BartekChelminski/-CD4093B-TSMC-180-nm-1P6M-1.8V/README.md

# CD4093B TSMC 180nm 1P6M 1.8V
Copy of a CD4093B integrated circuit (4 2-Input NAND Schmitt Triggers) made in TSMC 180 nm 1P6M 1.8V technology. Designed as a university project using LTspice and Magic VLSI.

Detailed presentation and simulation results are in the pdf file in folder docs.

# Images
## Functional diagram
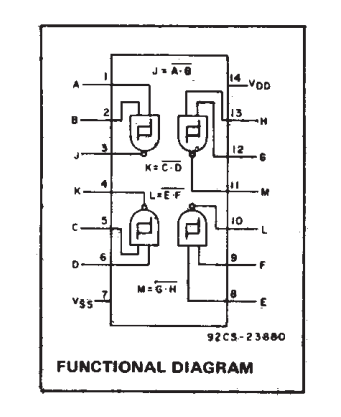
[picture p1: img/functional_diagram.png]
Functional diagram

## Full chip layout
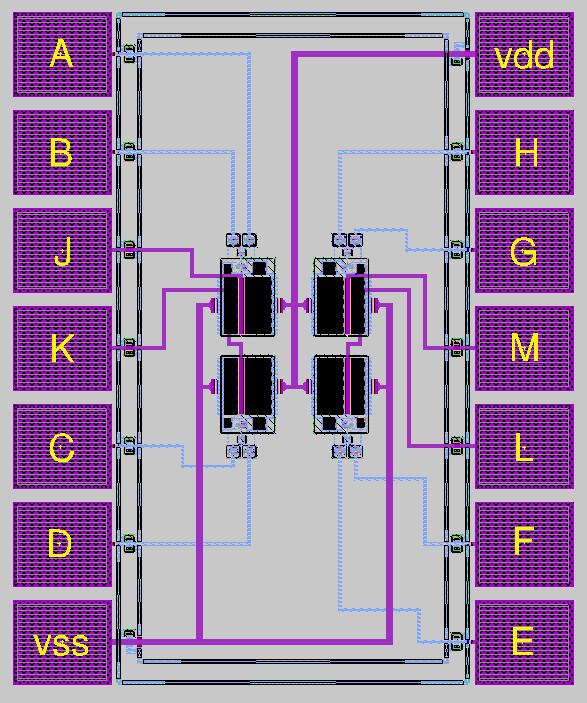
[picture p2: img/layout.png]
Layout

## Single Gate layout
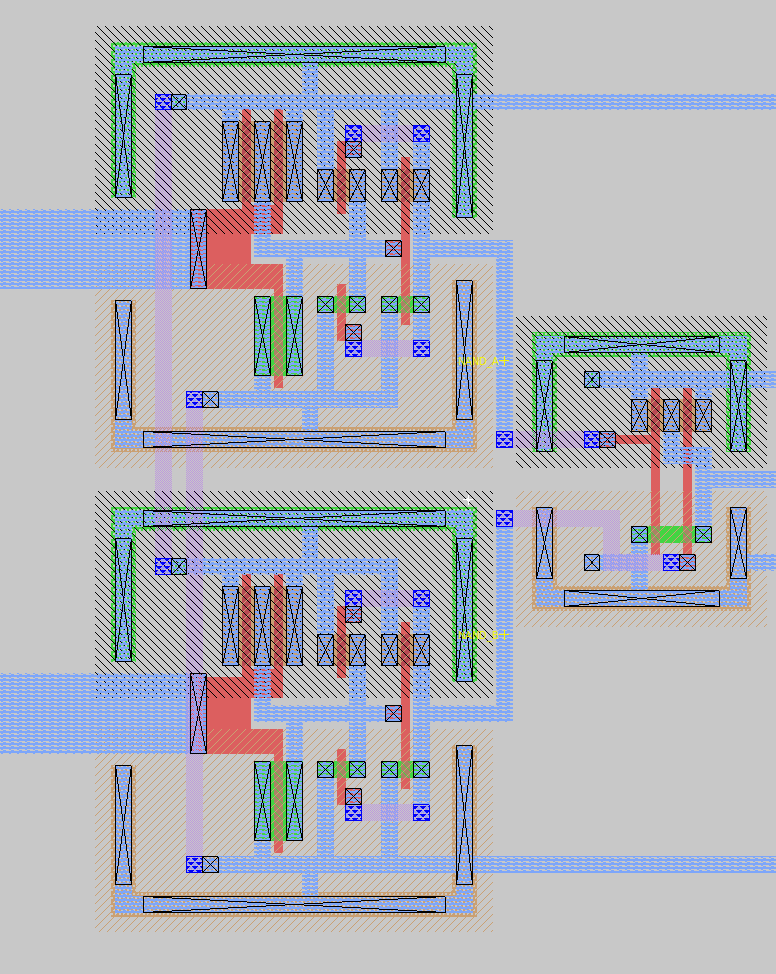
[picture p3: img/nand_schmitt.png]
nand_schmitt
