BartekChelminski/-CD4093B-TSMC-180-nm-1P6M-1.8V/doc/[ENG]project_presentation.pdf

Project topic: CD4093B

4 NAND gates with hysteresis


Project requirements

- Technology: CMOS TSMC 180 nm, 1P6M, 1.8 V
- Latch-up protection
- Electromigration protection
- PAD cells with dimensions (width × length): 60 µm × 70 µm, in no-devices-under-pad configuration
- ESD protection implemented using diodes or transistors
- Output current drive capability: IO ≥ 15 mA (DC) under conditions:
- VDD = 1.8 V ±10%
- Temperature range: −30°C to +125°C
- Output frequency: at least 30 MHz with 25 pF load, under conditions:
- VDD = 1.8 V ±10%
- Temperature range: −30°C to +125°C

Single gate schematic

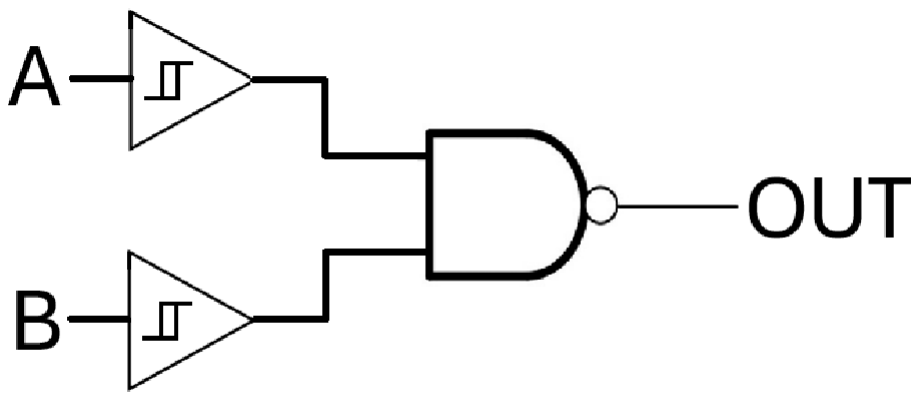
[picture p4: figure]

NAND gate

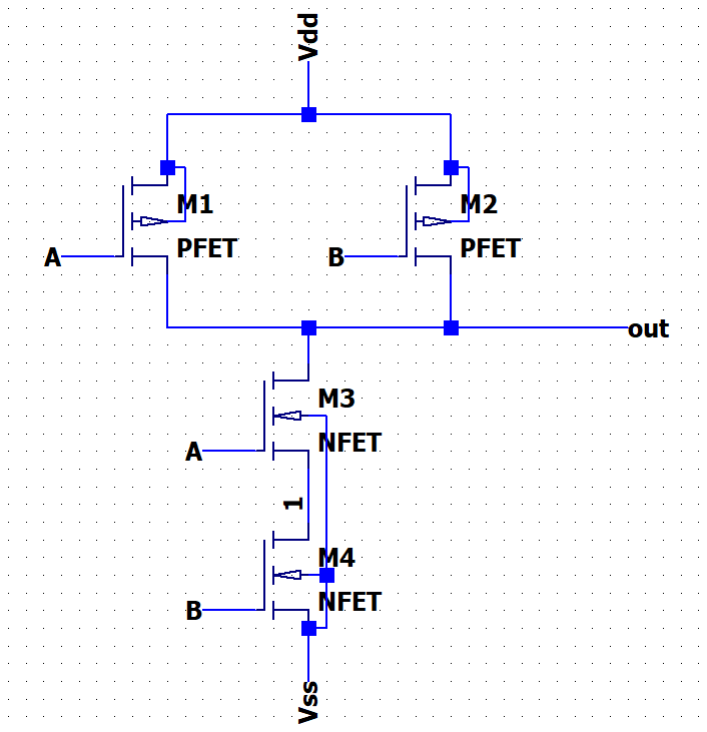
[picture p5: figure]
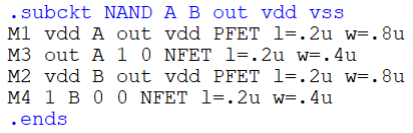
[picture p6: figure]
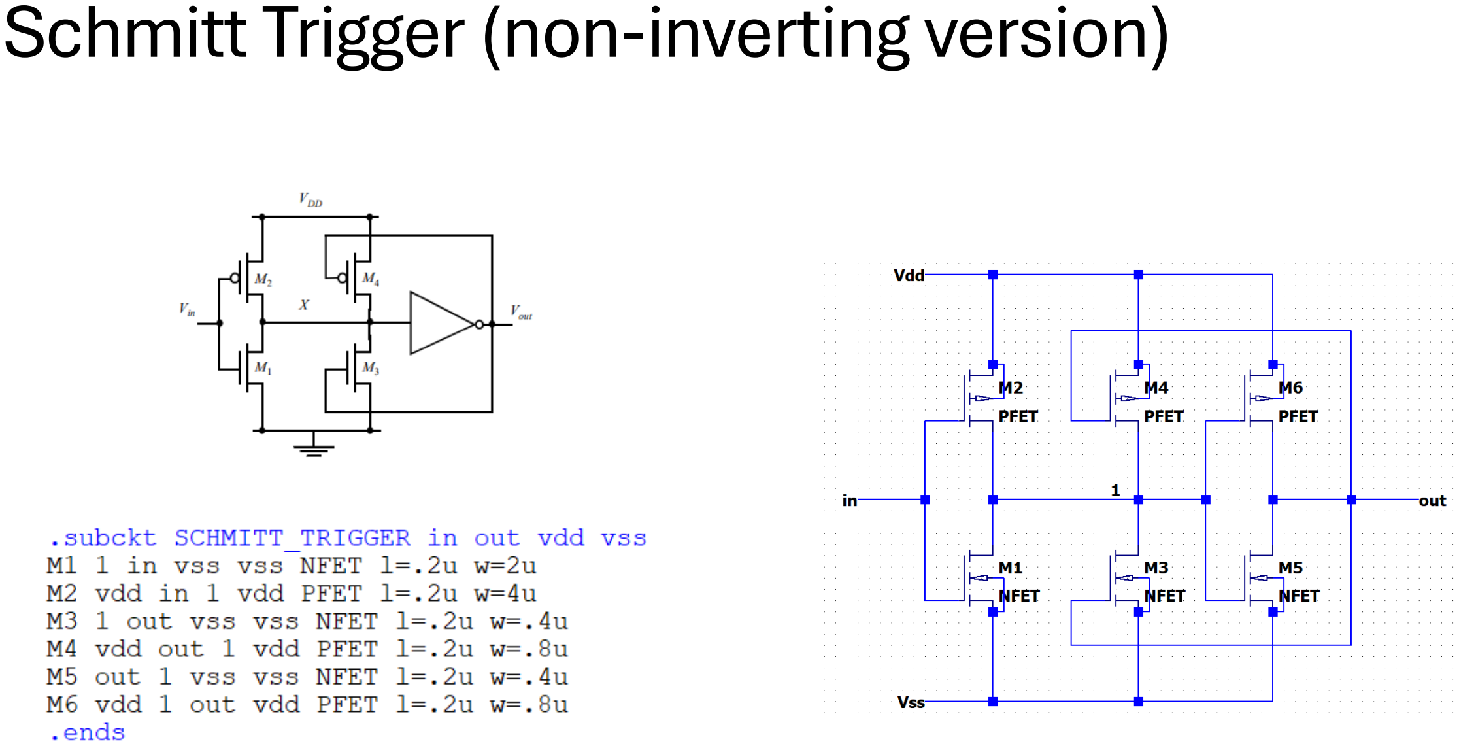
[picture p7: page 5]

Schmitt Trigger (non-inverting version)

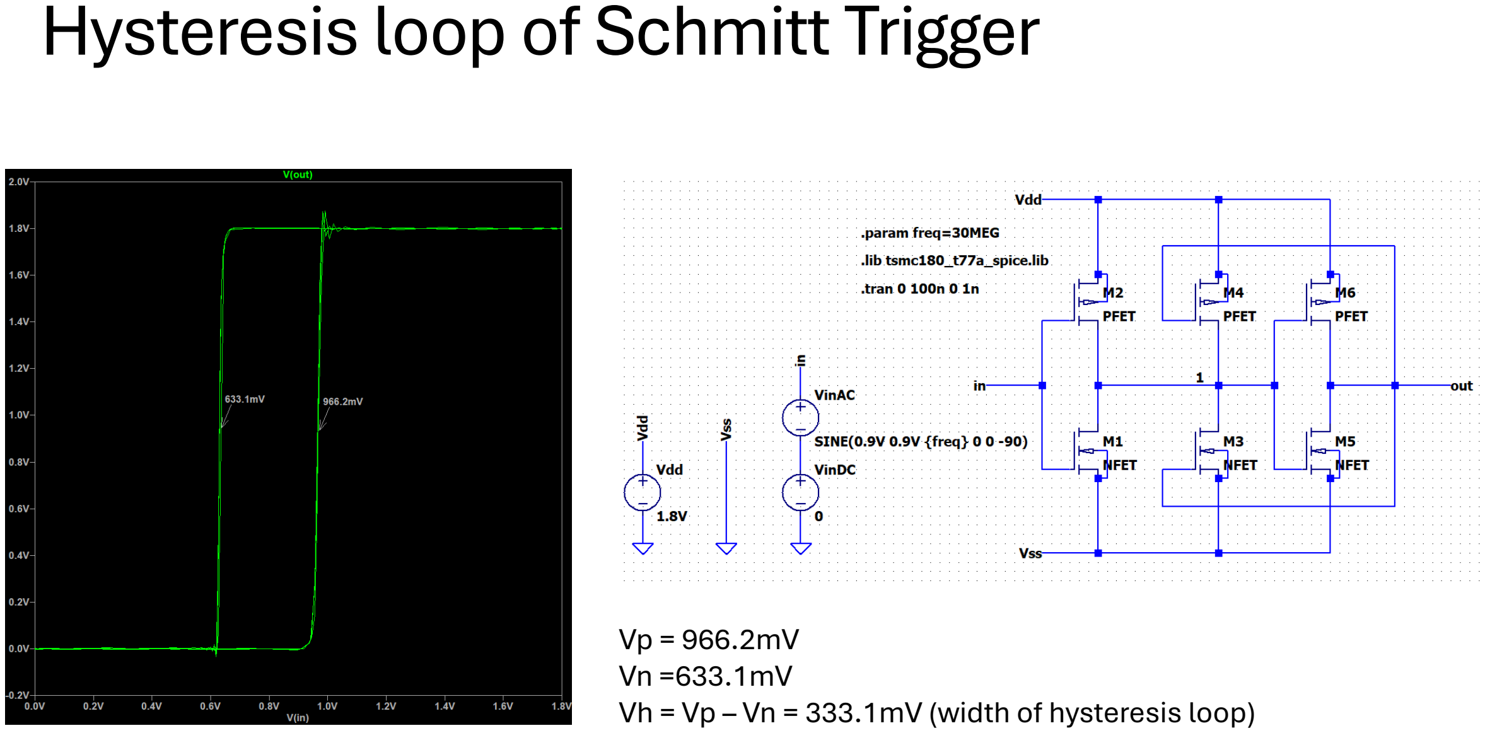
[picture p8: page 6]

Hysteresis loop of Schmitt Trigger

Vp = 966.2mV
Vn =633.1mV
Vh = Vp – Vn = 333.1mV (width of hysteresis loop)

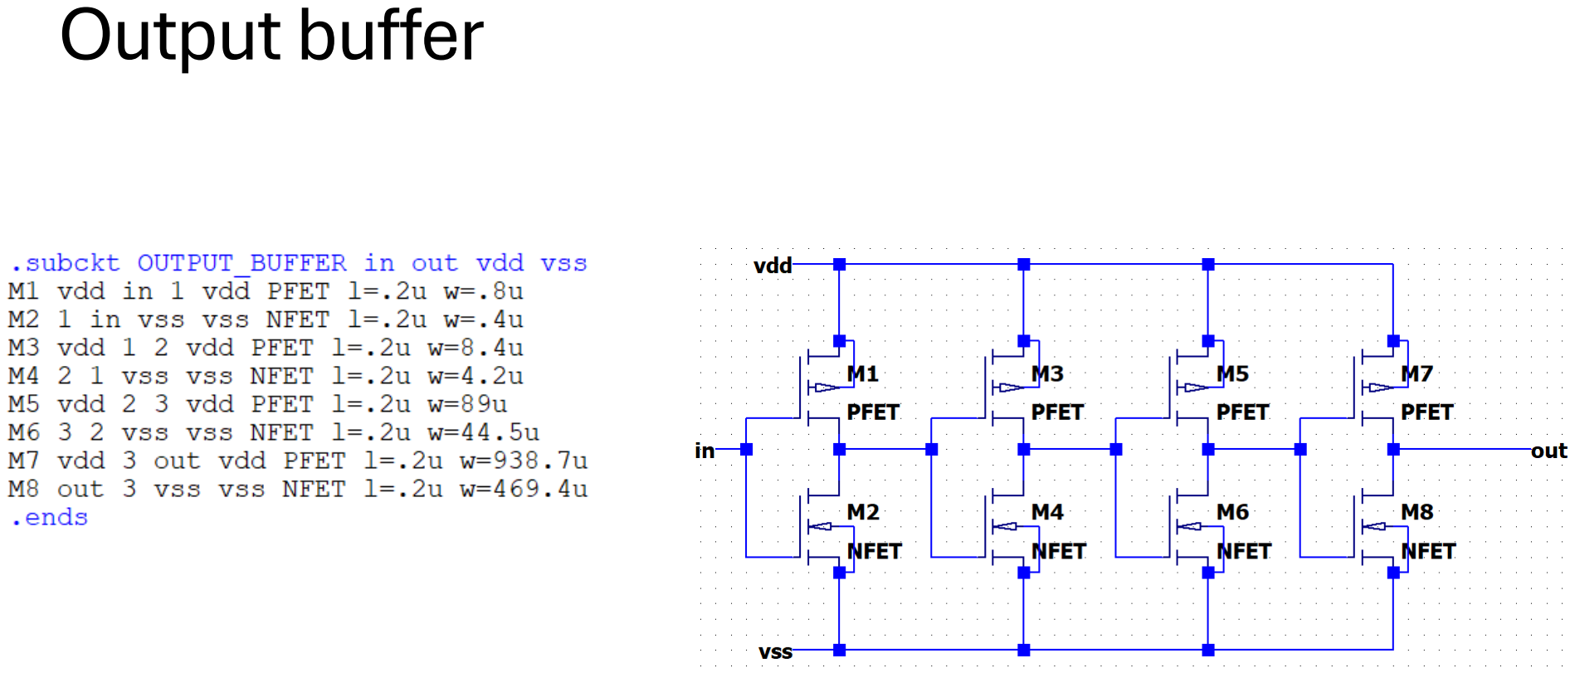
[picture p9: page 7]

Output buffer

Theoretical calculations for buffer design

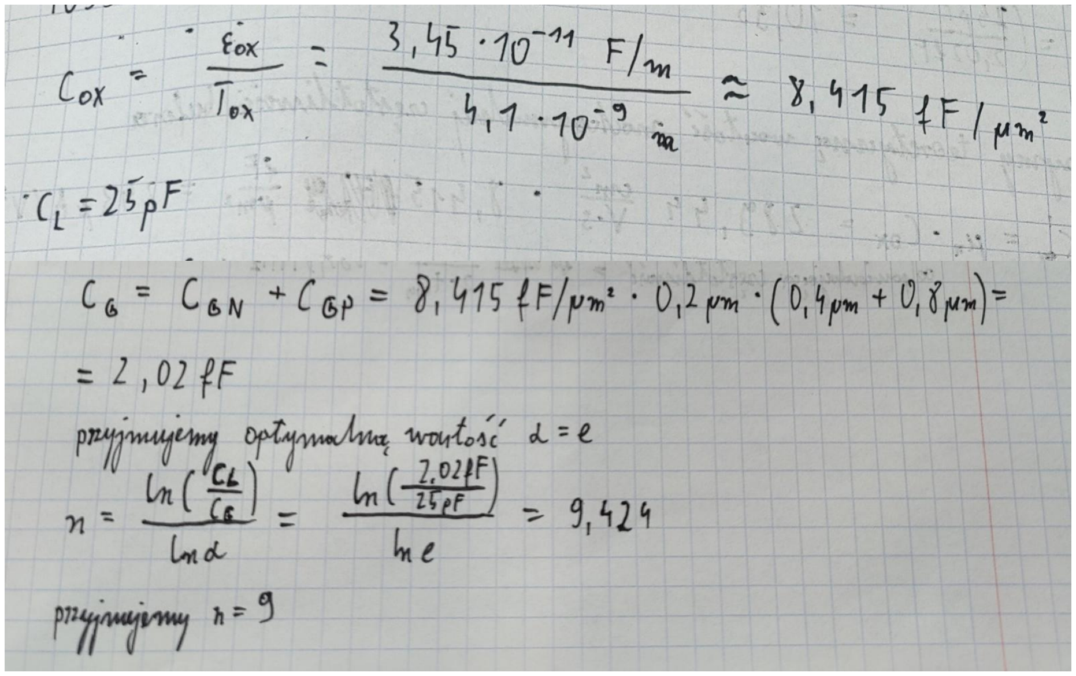
[picture p10: figure]

Theoretical calculations for buffer design

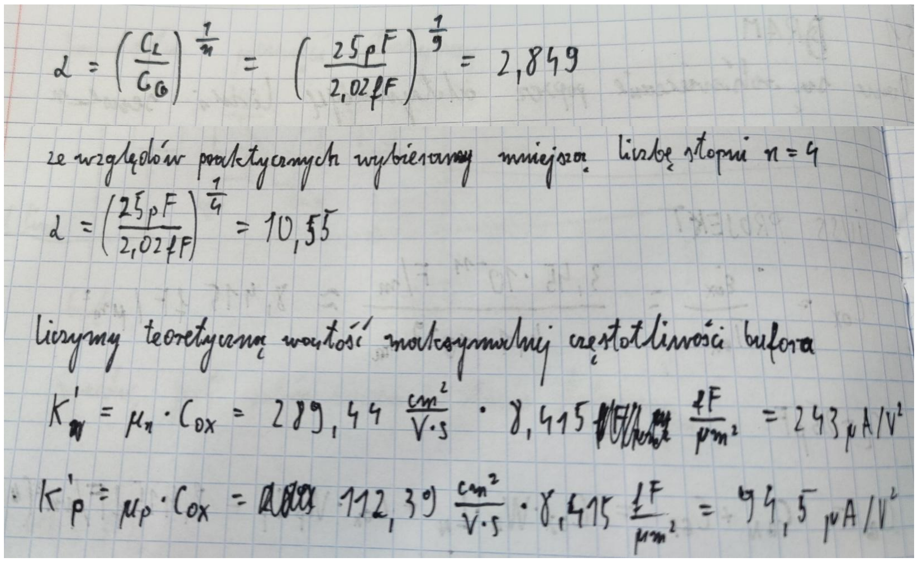
[picture p11: figure]

Theoretical calculations for buffer design

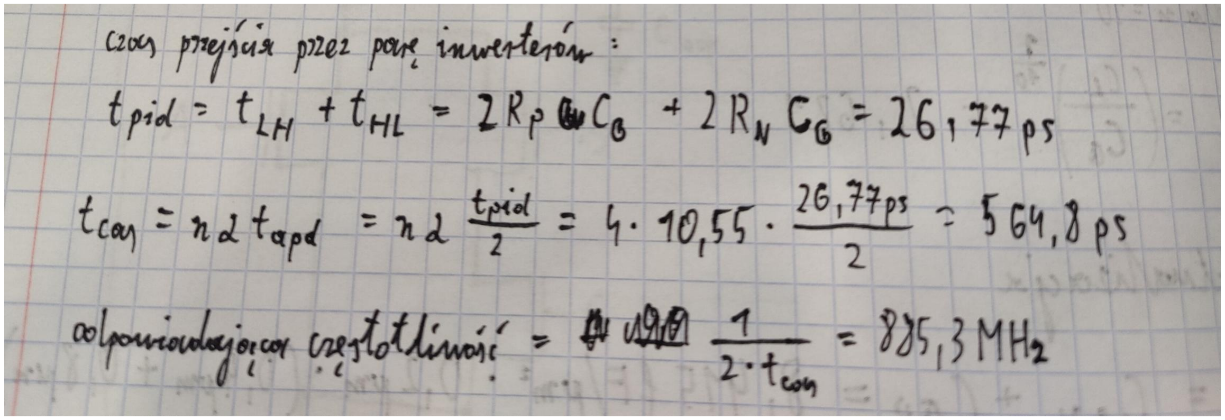
[picture p12: figure]

Buffer output waveform at 30 MHz

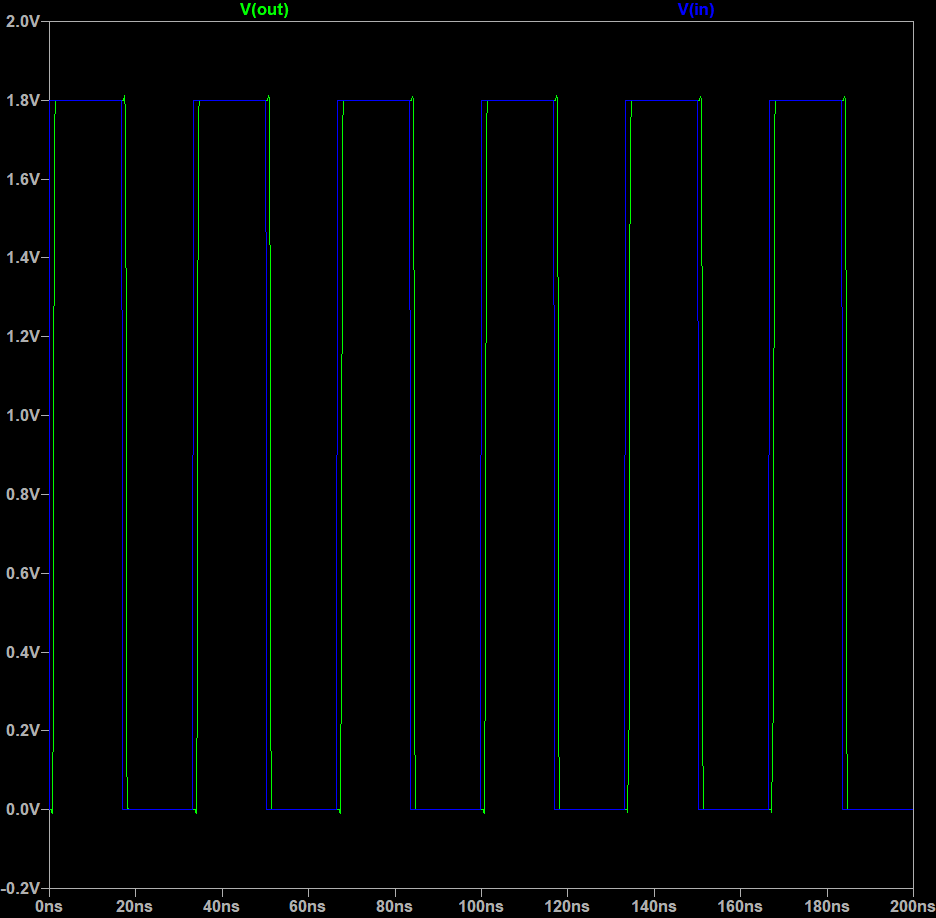
[picture p13: figure]

Buffer output waveform at 30 MHz for maximum and minimum temperature and VDD

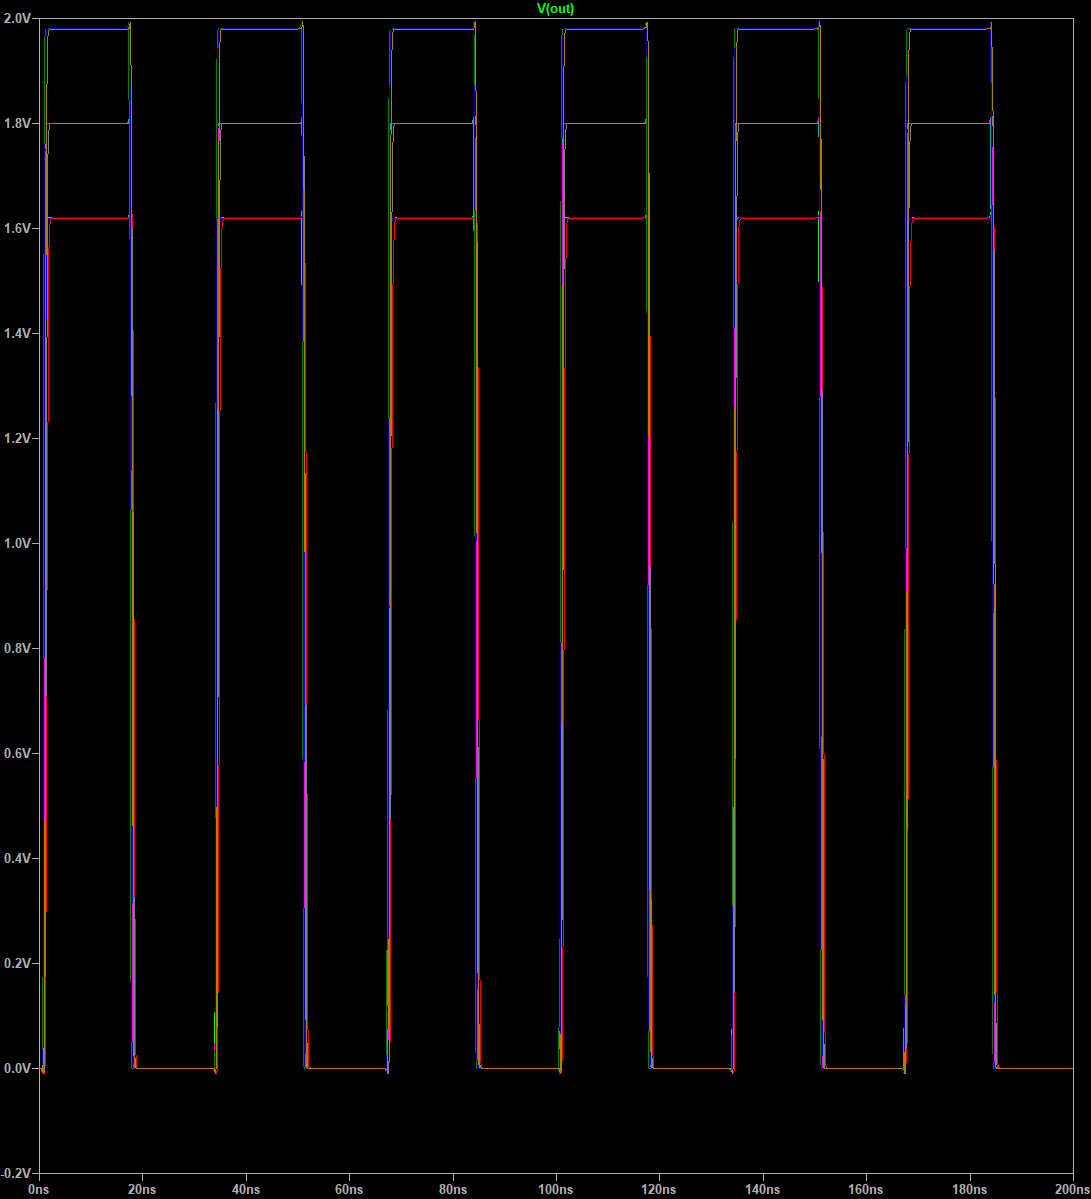
[picture p14: figure]

Maximum operating frequency of the buffer: approx. 630 MHz

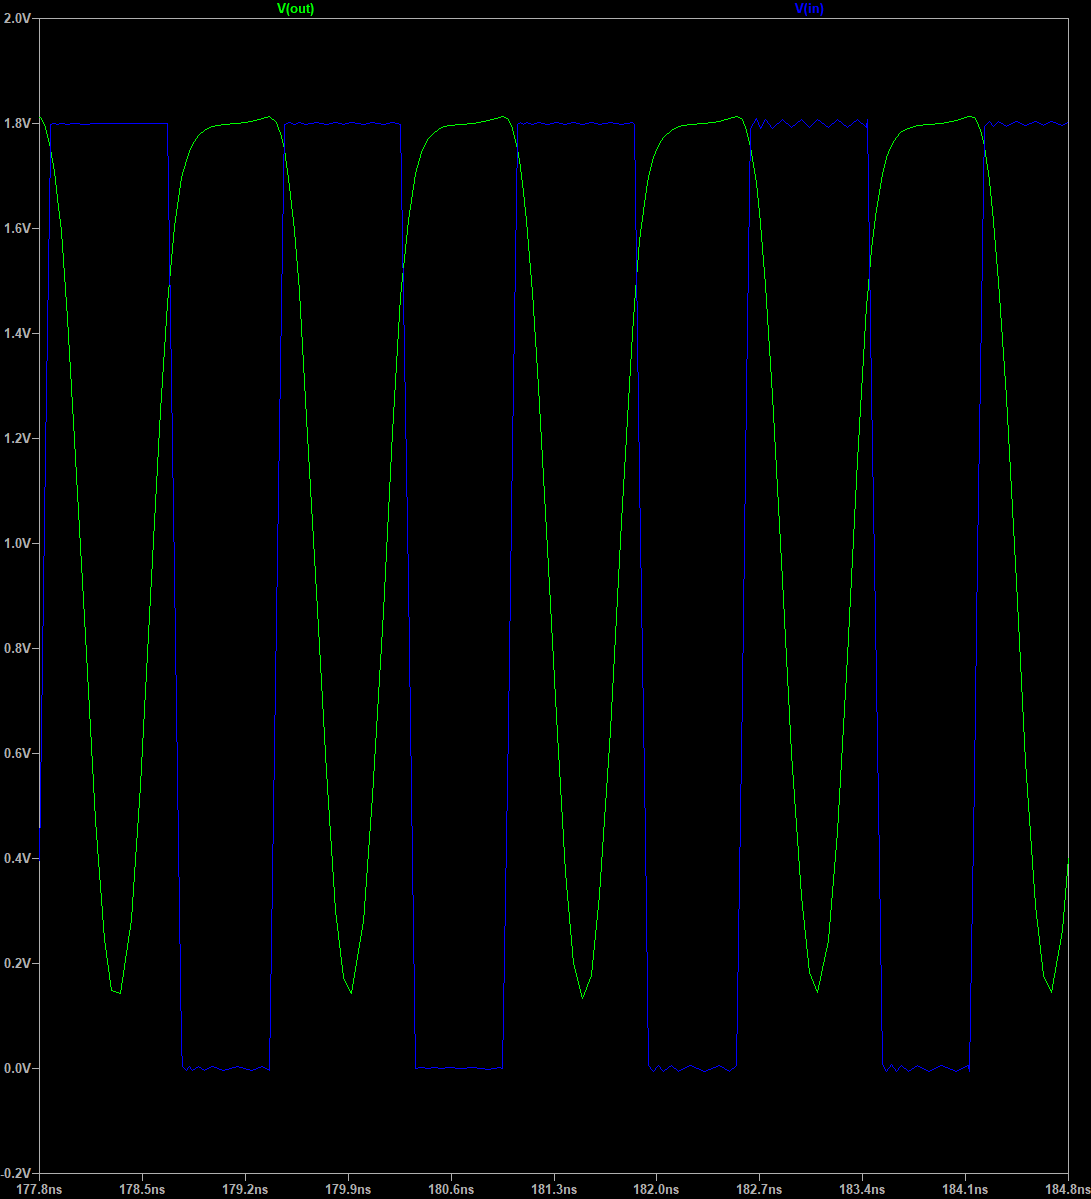
[picture p15: figure]

Rise time

Rising time is 326.1ps

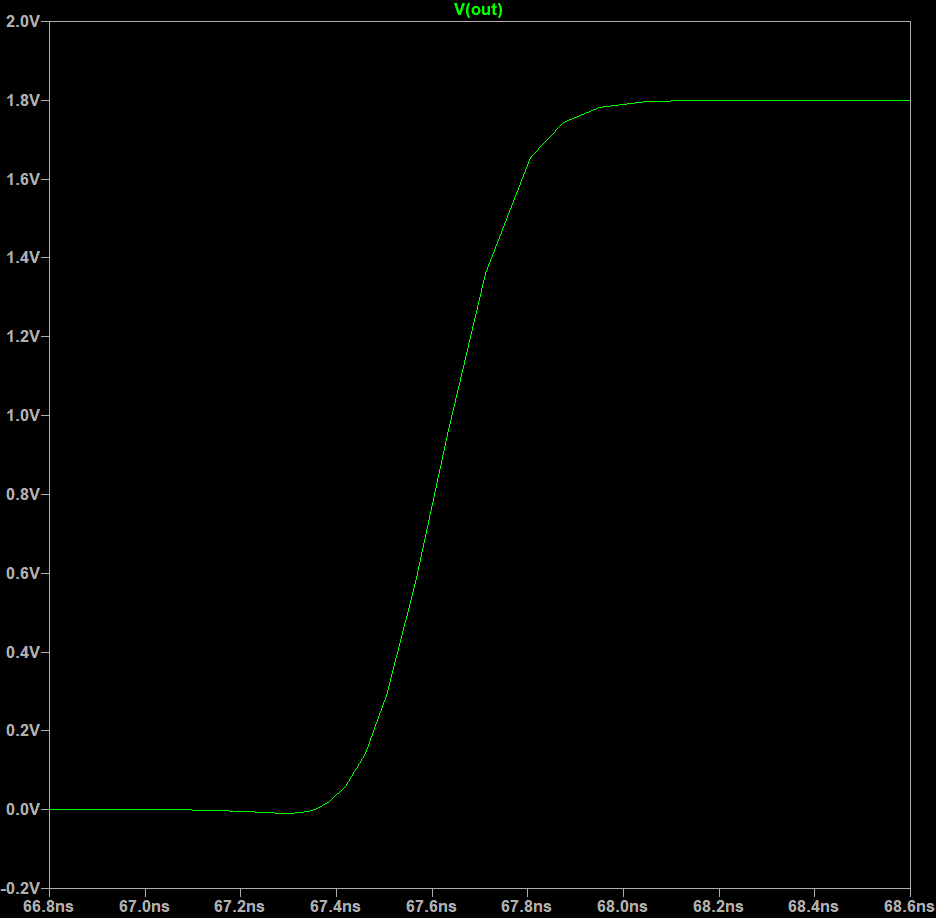
[picture p16: figure]

Fall time

Fall time is 313ps

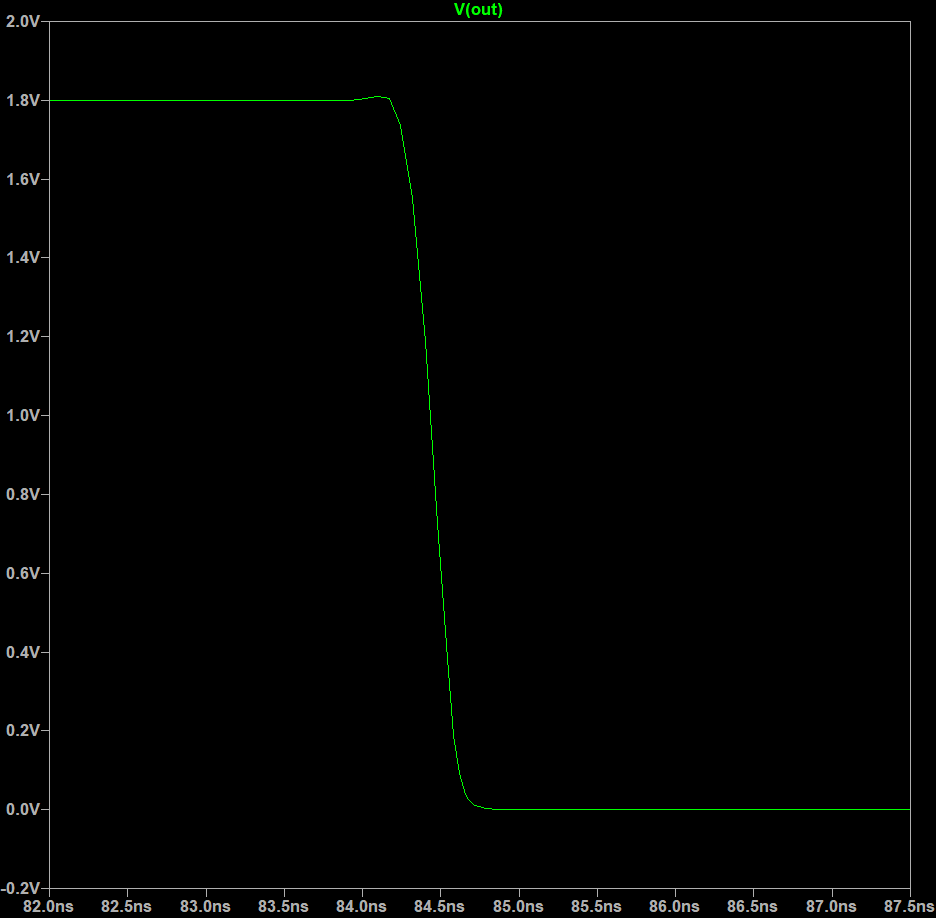
[picture p17: figure]
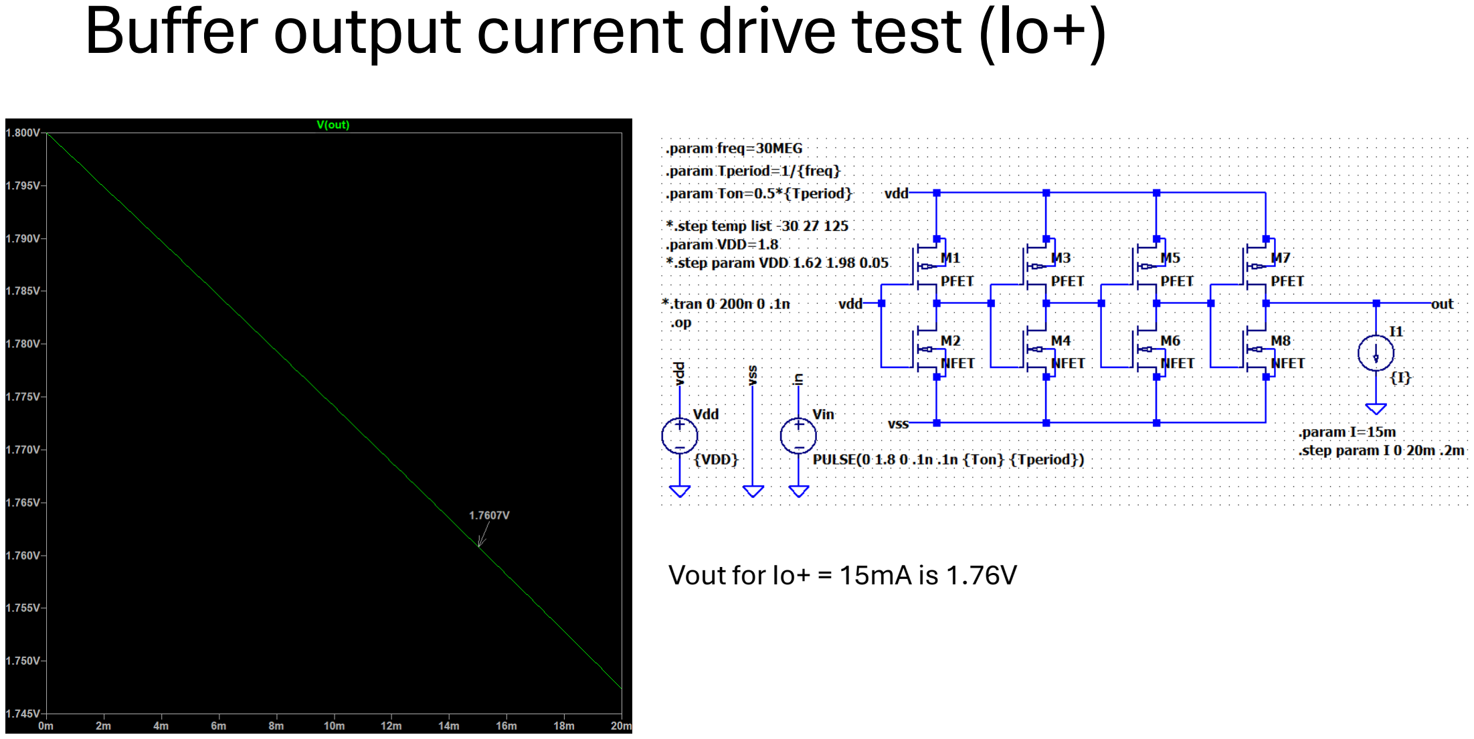
[picture p18: page 16]

Buffer output current drive test (Io+)

Vout for Io+ = 15mA is 1.76V

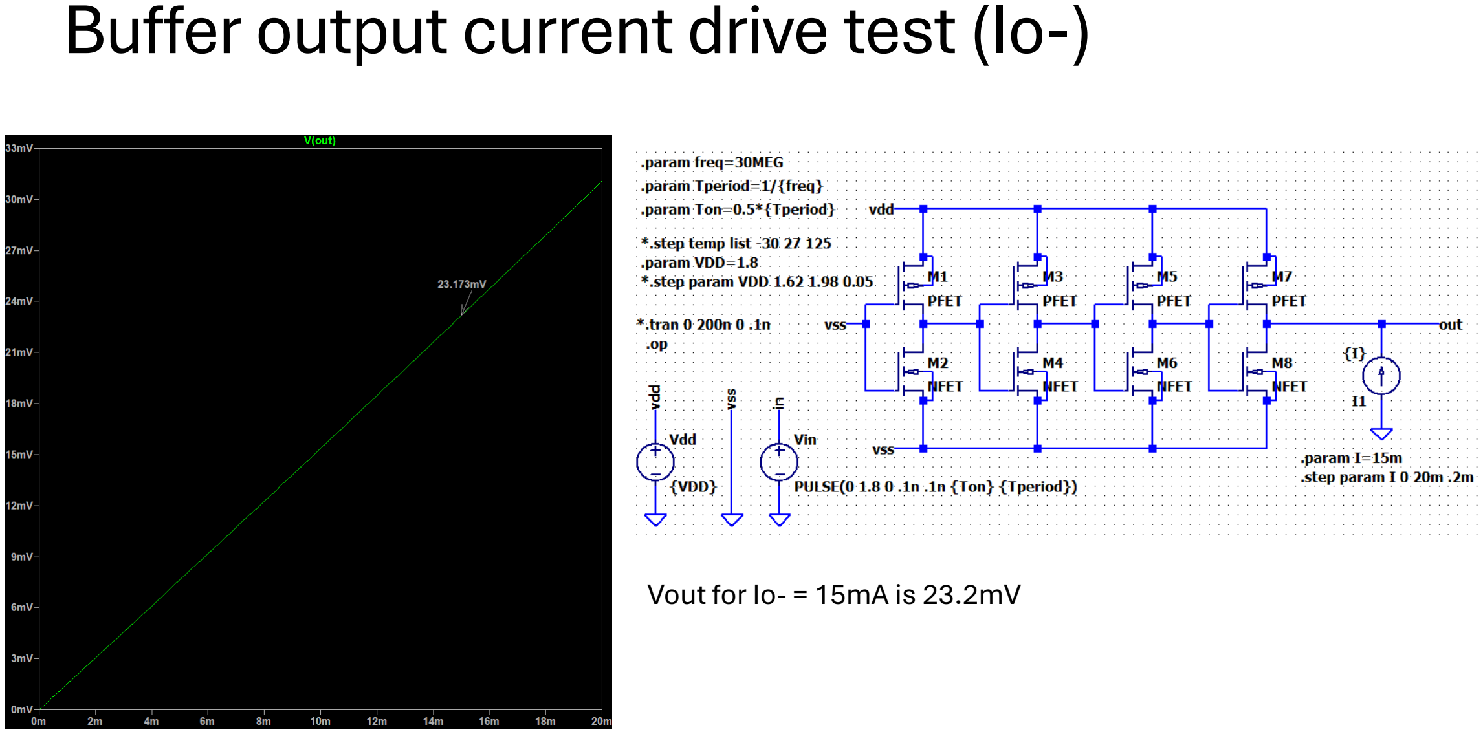
[picture p19: page 17]

Buffer output current drive test (Io-)

Vout for Io- = 15mA is 23.2mV

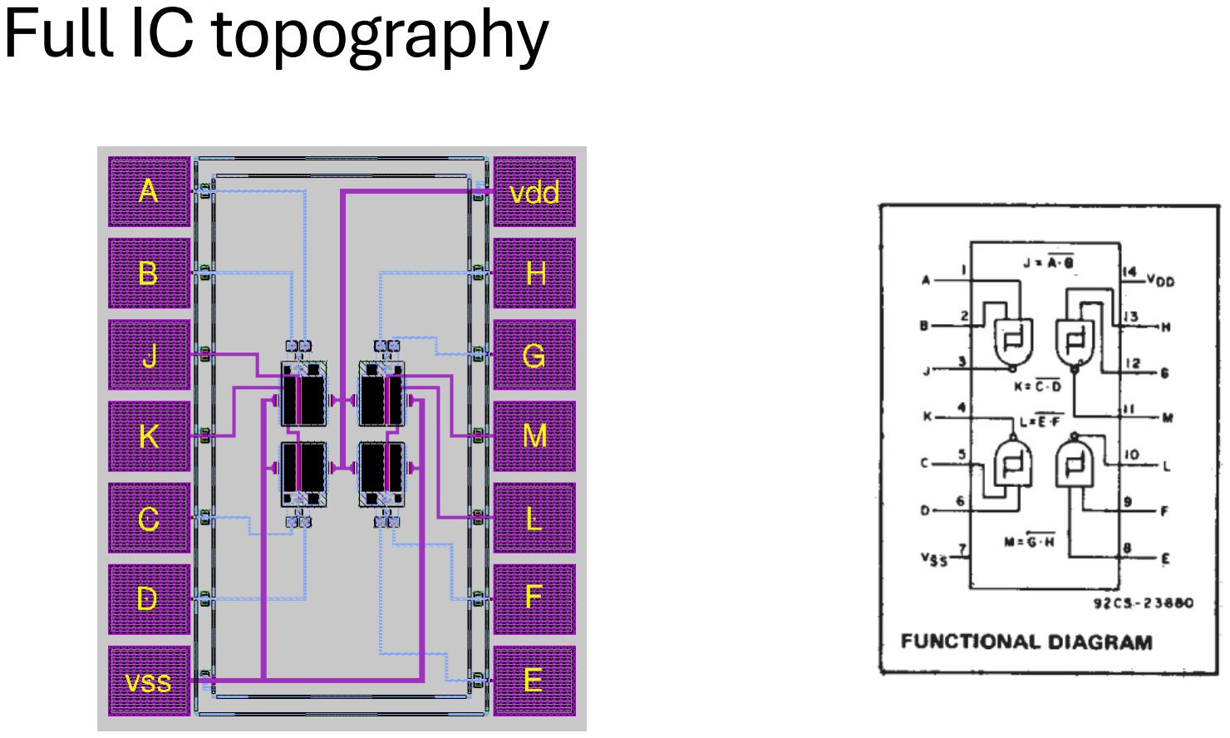
[picture p20: page 18]

Full IC topography

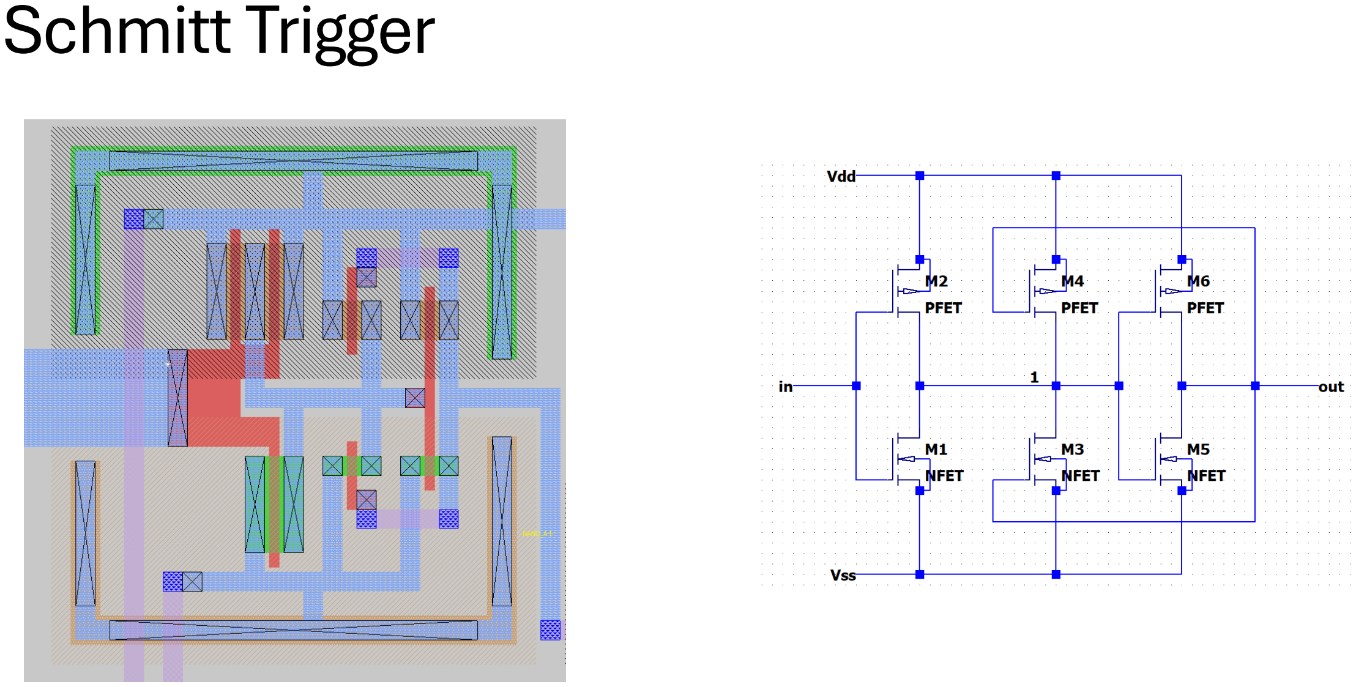
[picture p21: page 19]

Schmitt Trigger

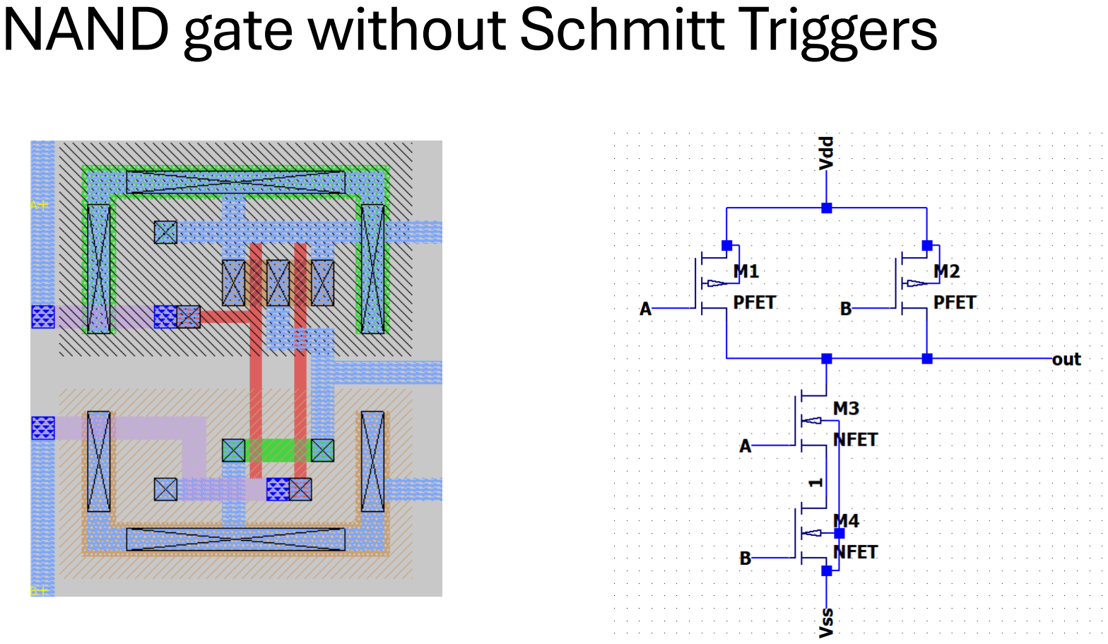
[picture p22: page 20]

NAND gate without Schmitt Triggers

NAND gate with Schmitt Triggers

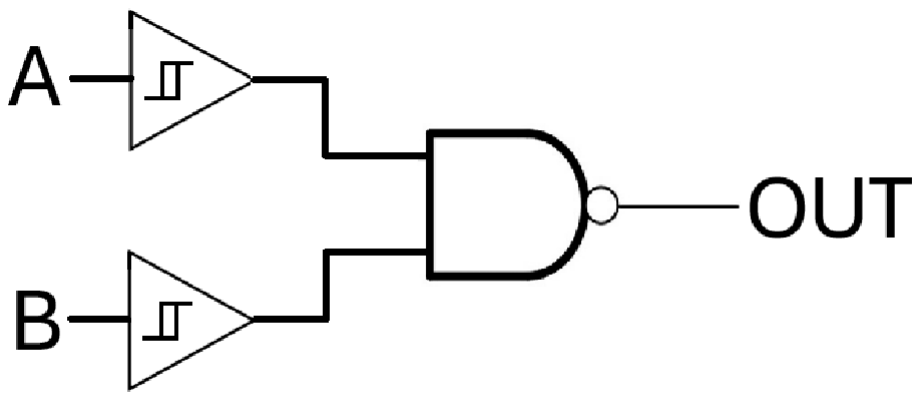
[picture p23: figure]
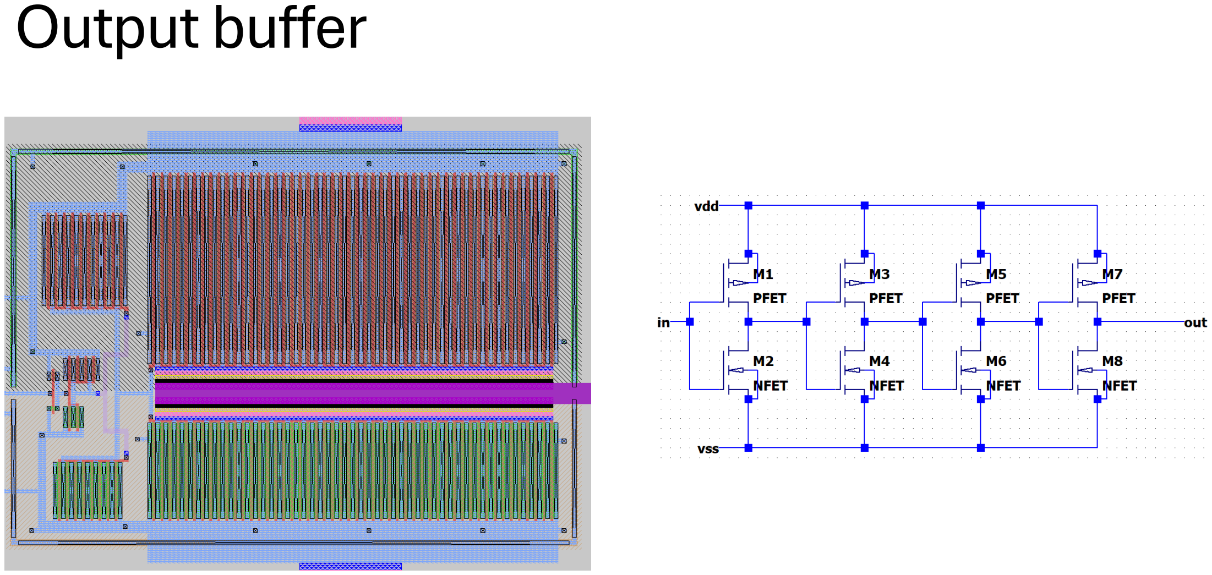
[picture p24: page 22]

Output buffer

Gate and the buffer

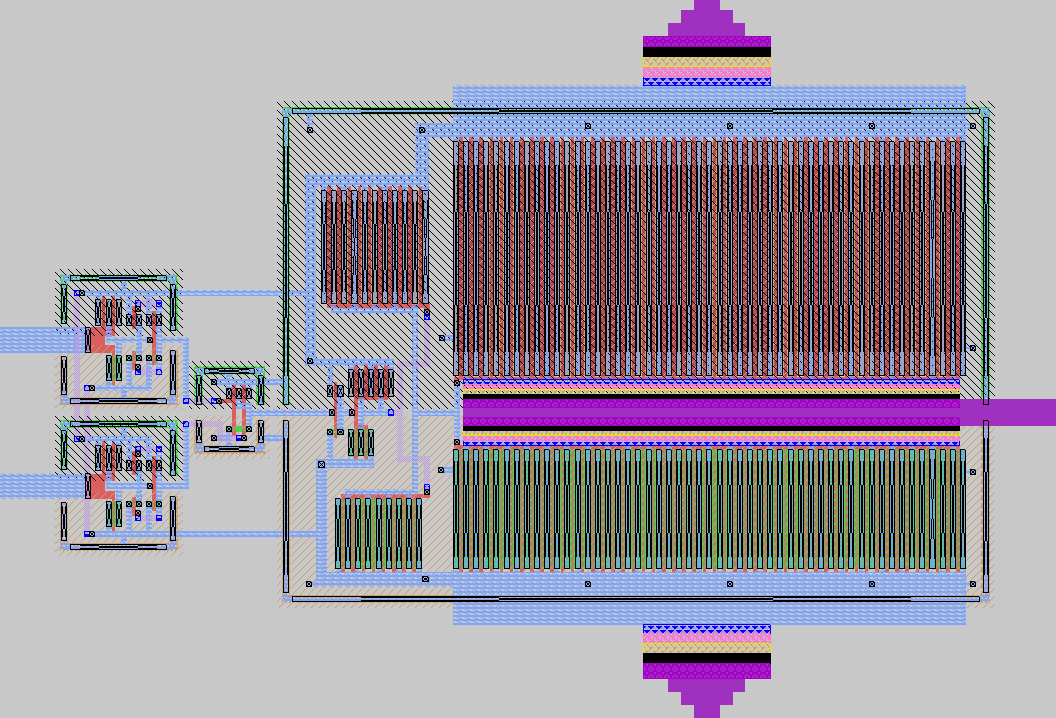
[picture p25: figure]

PAD

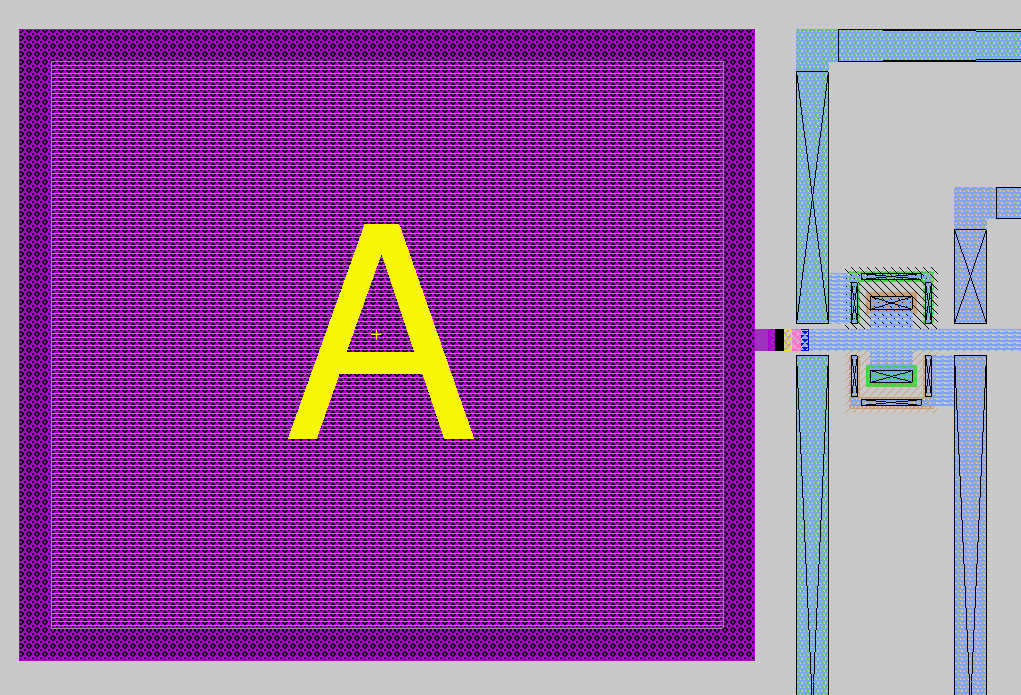
[picture p26: figure]
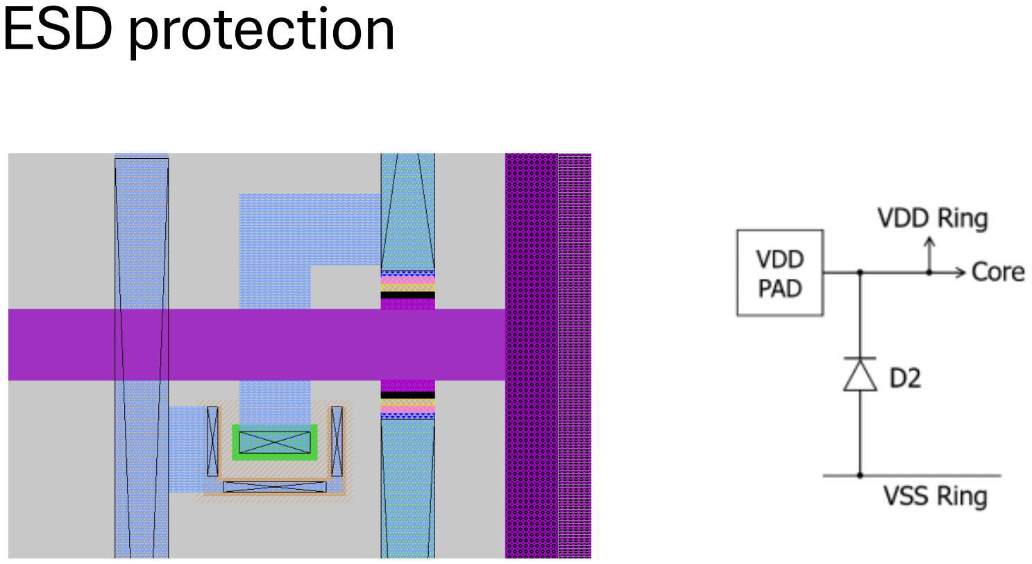
[picture p27: page 25]

ESD protection

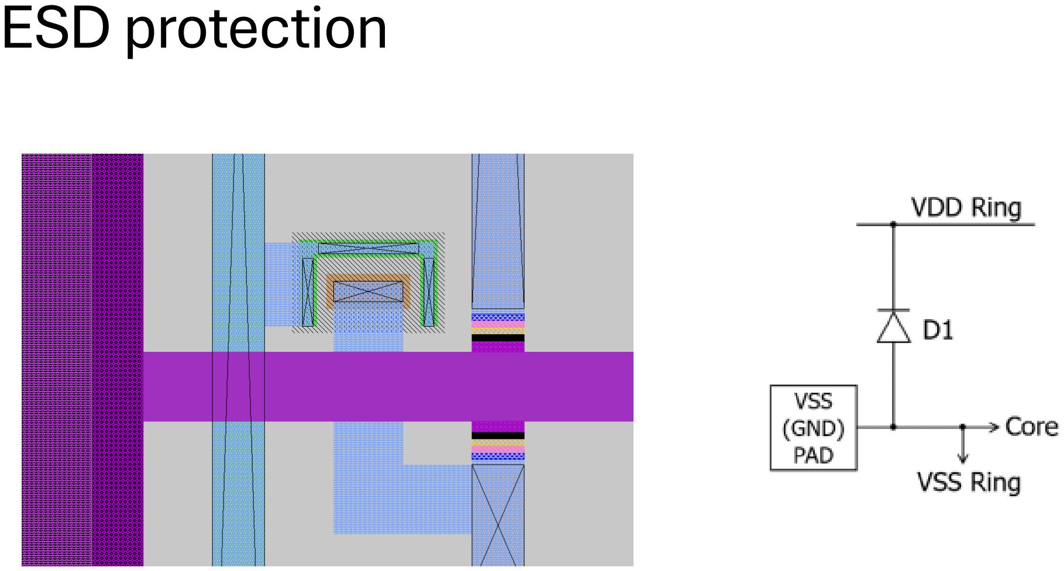
[picture p28: page 26]

ESD protection

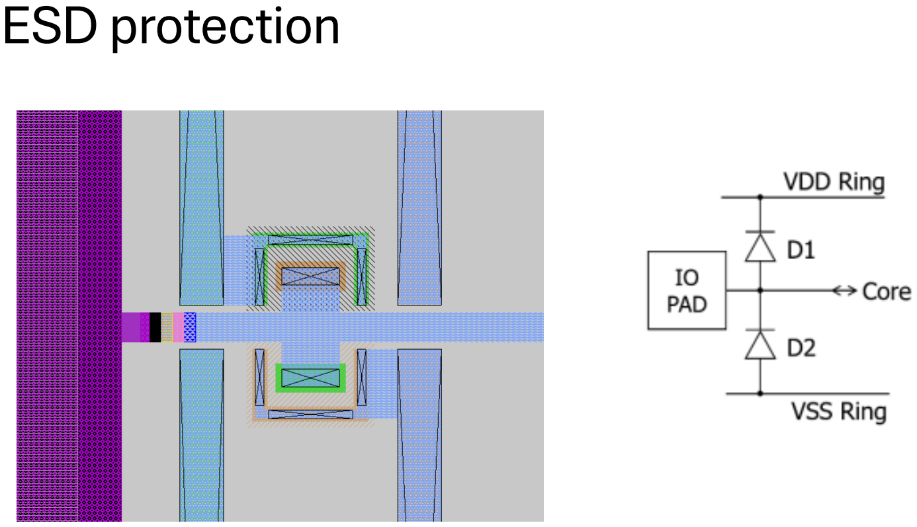
[picture p29: page 27]

ESD protection

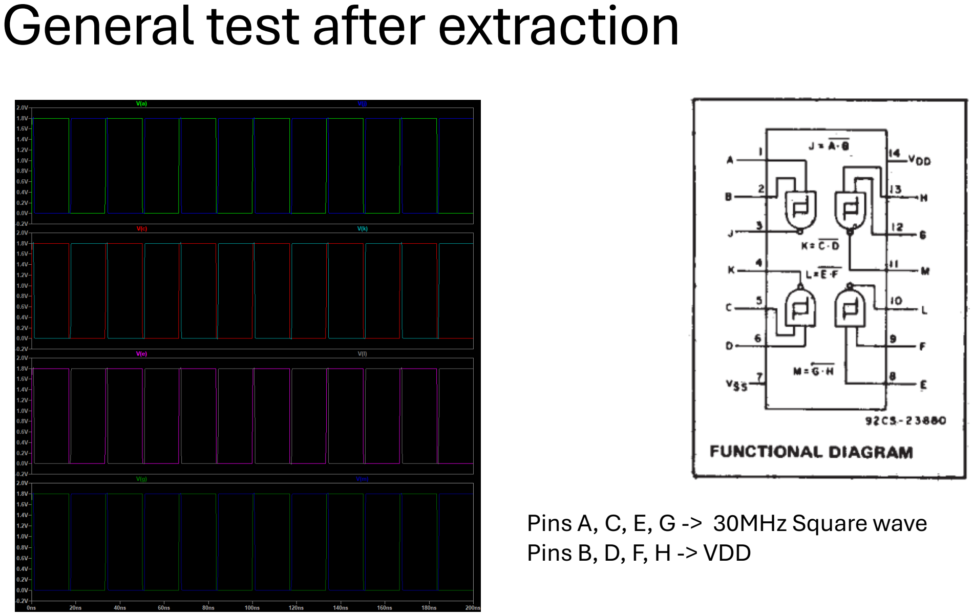
[picture p30: page 28]

General test after extraction

Pins A, C, E, G -> 30MHz Square wave Pins B, D, F, H -> VDD

Hysteresis loop of Schmitt Trigger

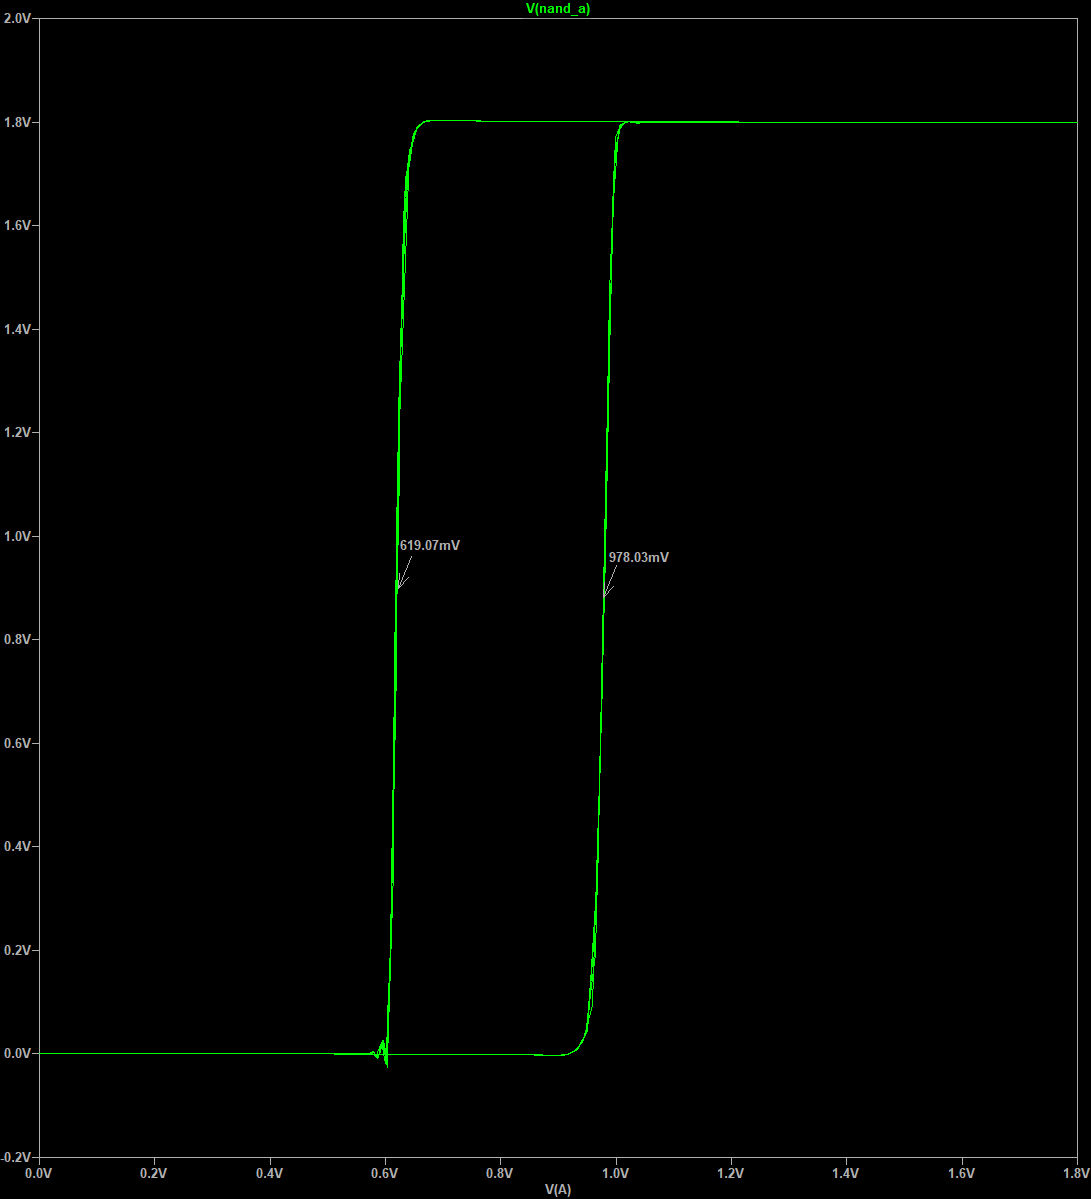
[picture p31: figure]

Pre-layout:
Vp = 966.2mV
Vn =633.1mV
Vh = Vp – Vn = 333.1mV

Post-layout:
Vp = 978.03mV
Vn = 619.07mV
Vh = 358.96mV

Buffer output waveform at 30 MHz

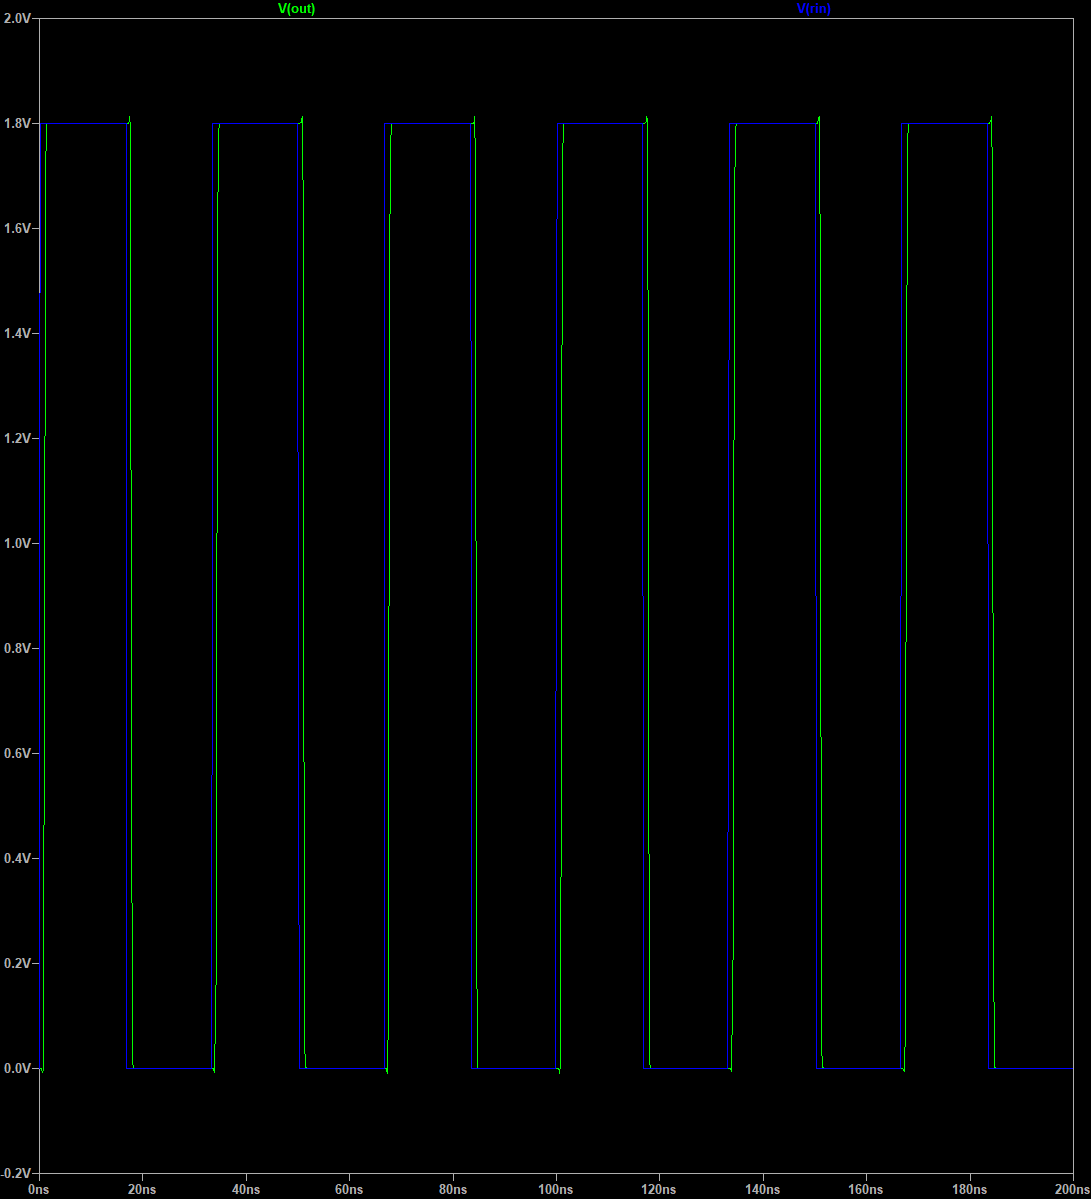
[picture p32: figure]

Buffer output waveform at 30 MHz for maximum and minimum temperature and VDD

Maximum operating frequency of the buffer: approx. 630 MHz (without change)

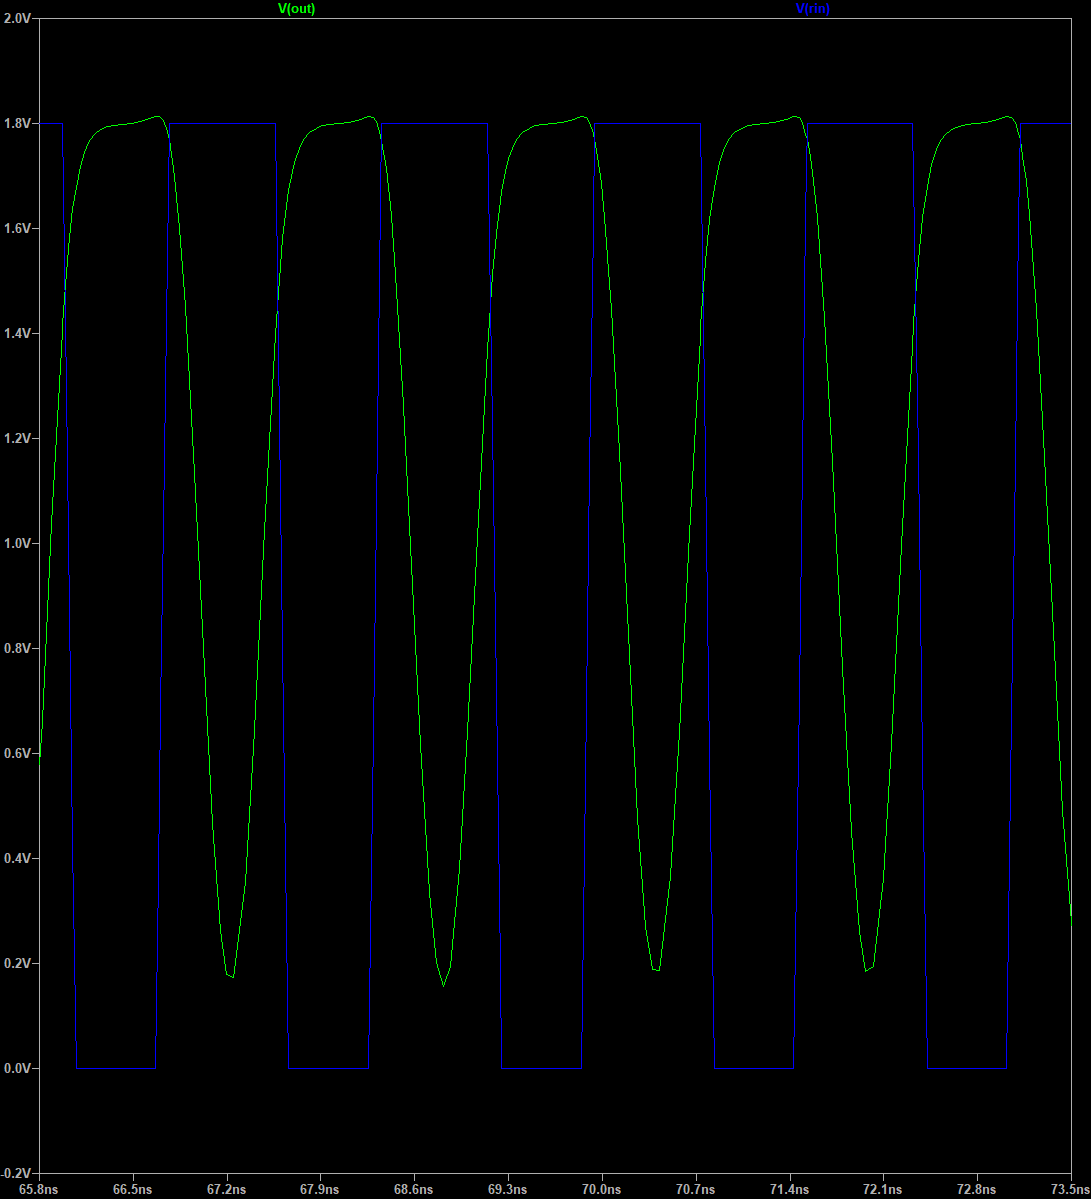
[picture p33: figure]

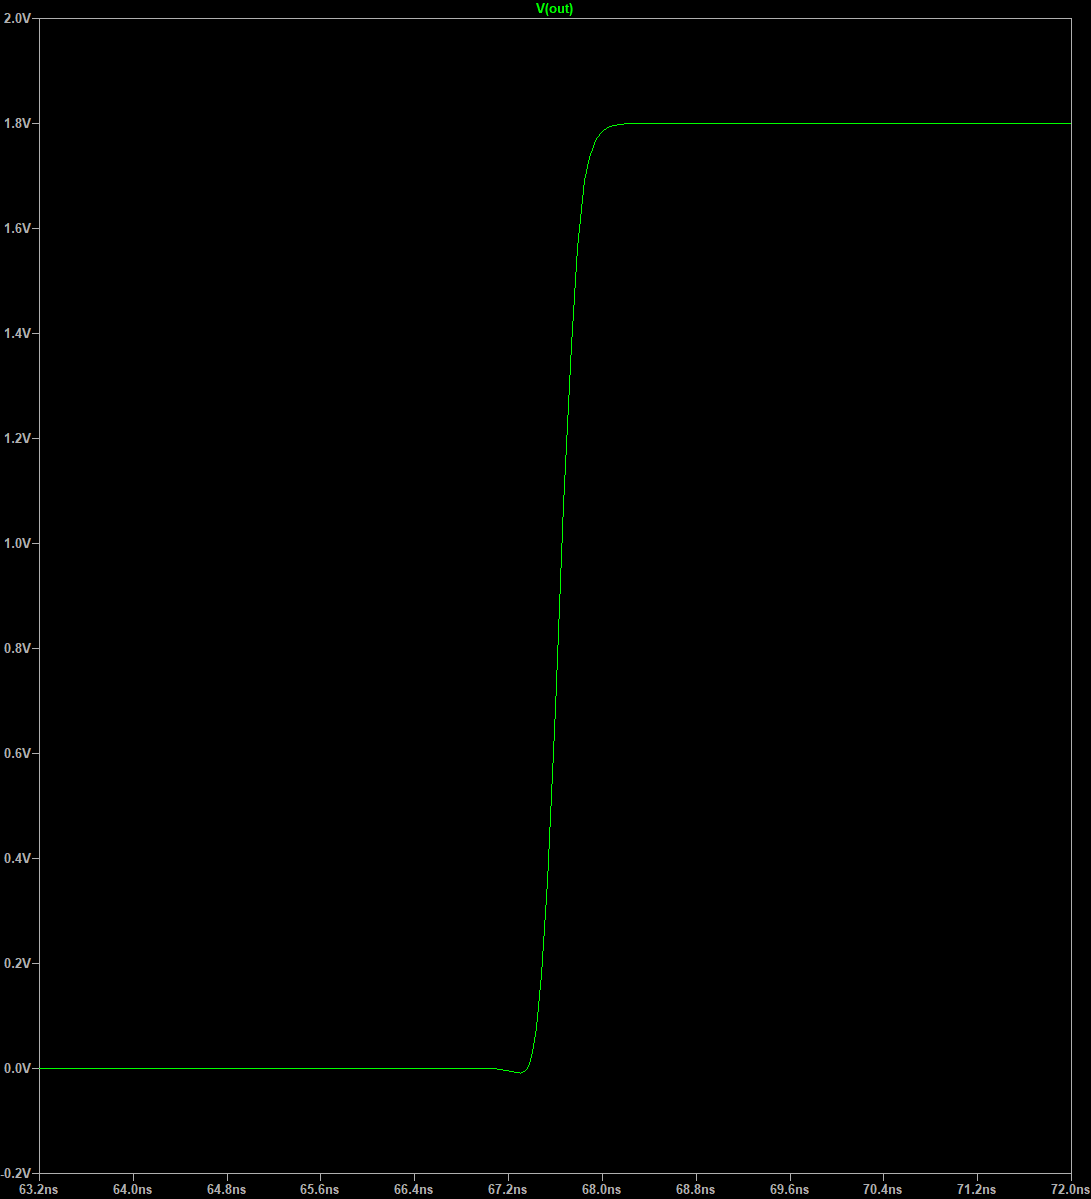
[picture p34: figure]

Rise time

Pre-layout:
326.1ps
Post-layout:
332.5ps

Fall time

Pre-layout:
313ps
Post-layout:
302.3ps

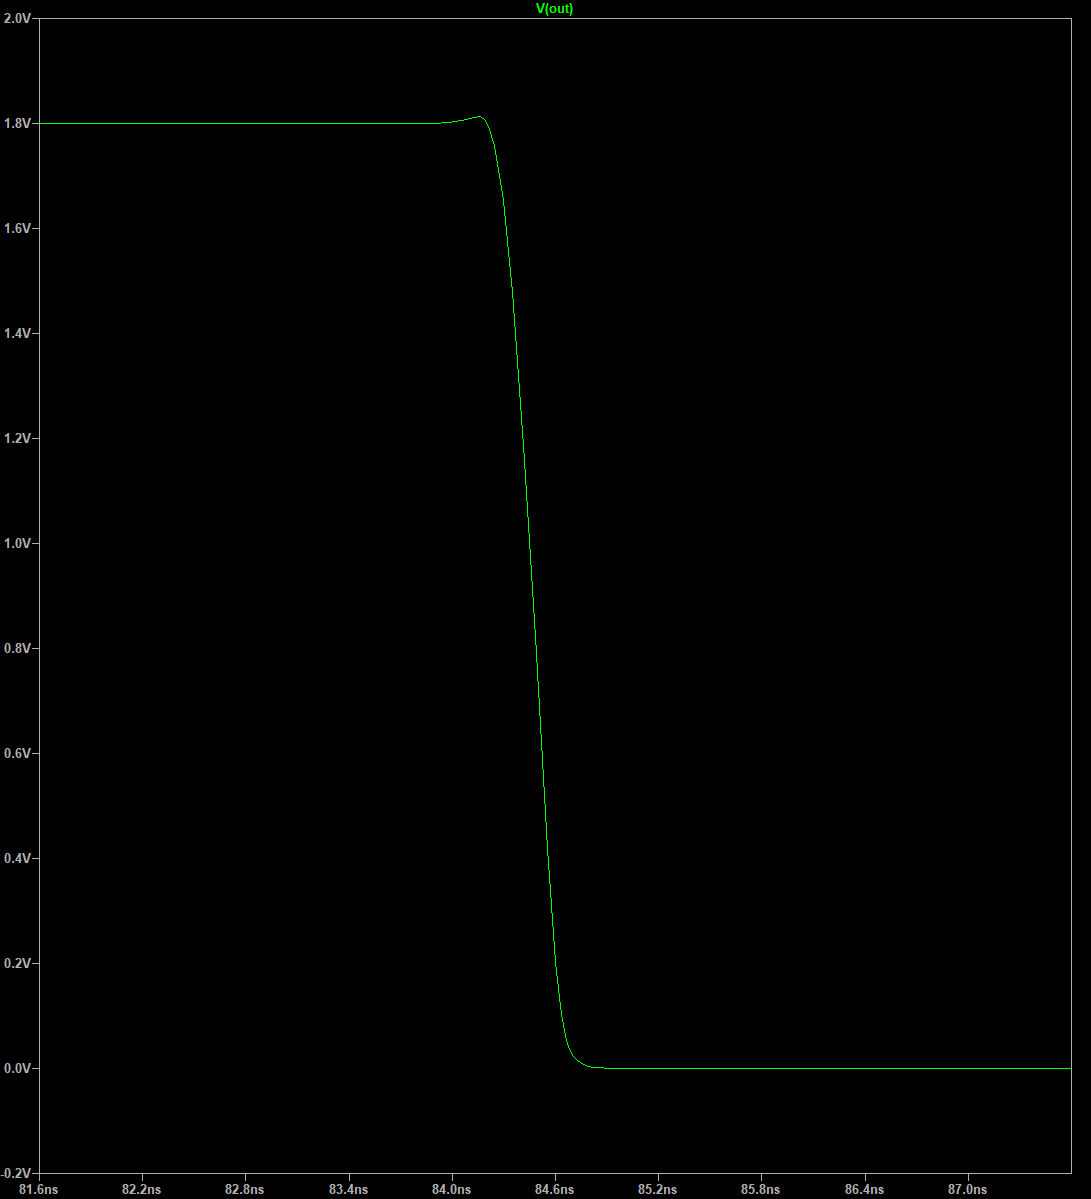
[picture p35: figure]

Buffer output current drive test (Io+)

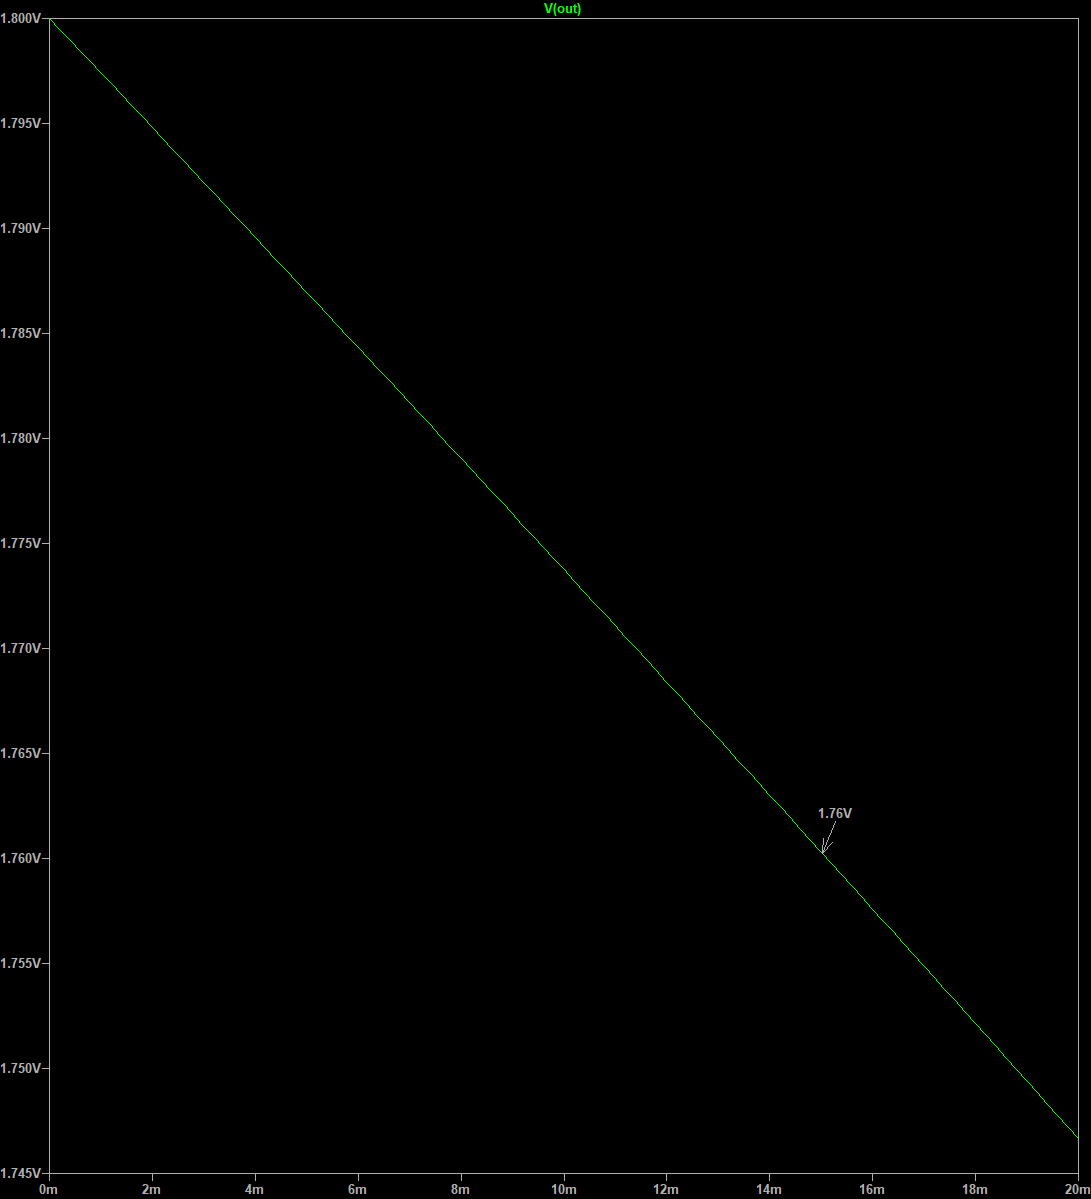
[picture p36: figure]

Pre-layout:
Vout for Io- = 15mA is 1.76V Post-layout
Vout for Io- = 15mA is 1.76V

Buffer output current drive test (Io-)

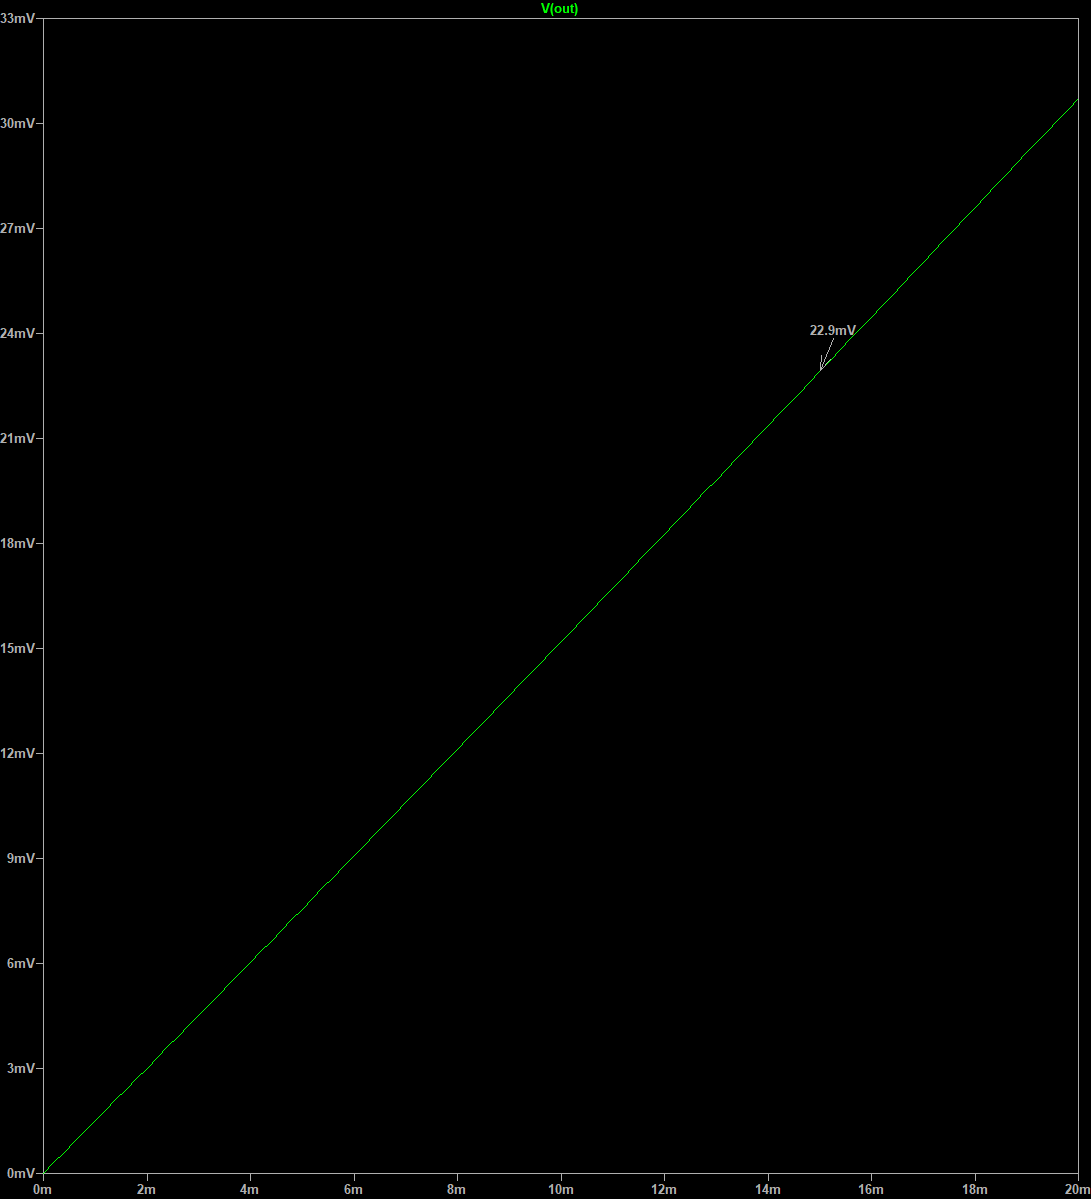
[picture p37: figure]

Pre-layout:
Vout for Io- = 15mA is 23.2mV Post-layout
Vout for Io- = 15mA is 22.9mV
