BartekChelminski/-CD4093B-TSMC-180-nm-1P6M-1.8V/sim/pre-layout/nand_gate.asc

M1: pmos4; PFET; l=.2u w=.8u
M2: pmos4; PFET; l=.2u w=.8u
M3: nmos4; NFET; l=.2u w=.4u
M4: nmos4; NFET; l=.2u w=.4u
R1: res; 1µ
Va: voltage; {Ain}
Vb: voltage; {Bin}
Vclock: voltage; PULSE(0 1.8 0 .1n .1n {Ton} {Tperiod})
Vdd: voltage; 1.8V
Named nets: Vdd, out, Vss, A, B, 0, 1
.lib tsmc180_t77a_spice.lib
.param Ain=0V
.param Bin=1.8V
.tran 0 200n 0 .2n
.dc Va 0 1.8 1m
.param freq=30MEG
.param Tperiod = 1/{freq}
.param Ton = 0.5*Tperiod
