BartekChelminski/-CD4093B-TSMC-180-nm-1P6M-1.8V/sim/pre-layout/output_buffer.asc

Cload: cap; 25p
I1: current; {I}
M1: pmos4; PFET; l=.2u w=.8u
M2: nmos4; NFET; l=.2u w=.4u
M3: pmos4; PFET; l=.2u w=8.4u
M4: nmos4; NFET; l=.2u w=4.2u
M5: pmos4; PFET; l=.2u w=89u
M6: nmos4; NFET; l=.2u w=44.5u
M7: pmos4; PFET; l=.2u w=938.7u
M8: nmos4; NFET; l=.2u w=469.4u
Vdd: voltage; {VDD}
Vin: voltage; PULSE(0 {VDD} 0 .1n .1n {Ton} {Tperiod})
Named nets: vdd, 0, vss, in, out
.tran 0 200n 0 .1n
.param freq=30MEG
.param Tperiod=1/{freq}
.param Ton=0.5*{Tperiod}
*.step temp list -30 27 125
*.step param VDD list 1.62 1.8 1.98
.param VDD=1.8
.lib tsmc180_t77a_spice.lib
.op
.param I=15m
*.step param I 0 20m .2m
