BartekChelminski/-CD4093B-TSMC-180-nm-1P6M-1.8V/sim/pre-layout/schmitt_trigger.asc

M1: nmos4; NFET; l=.2u w=2u
M2: pmos4; PFET; l=.2u w=4u
M3: nmos4; NFET; l=.2u w=.4u
M4: pmos4; PFET; l=.2u w=.8u
M5: nmos4; NFET; l=.2u w=.4u
M6: pmos4; PFET; l=.2u w=.8u
Vdd: voltage; 1.8V
VinAC: voltage; SINE(0.9V 0.9V {freq} 0 0 -90)
VinDC: voltage; 0
Named nets: in, out, Vss, Vdd, 0, 1
.lib tsmc180_t77a_spice.lib
.tran 0 100n 0 1n
.param freq=30MEG
